reffum/digitizer/docs/Подключение АЦП к плате ZYBO.odt

# Подключение платы АЦП к ZYBO.

Для подключения LVDS линий от АЦП можно использовать разъемы, которые на схеме подключены к цепям JA, JB, JC, JD. Можно также использовать линии HDMI. Clock АЦП нужно подключить к HDMI_CLK или к JD3_P/JD3_N.

Важное замечание. Если данные передаются в формате LVDS, то нужно поставить терминирующий резистор 100 Ом, либо на стороне приемника , либо на стороне передатчика. Лучше разумеется на стороне приемника, то есть на плате.

## Подключение SPI

Линии SPI подключаются к порту MIO Pmod

Линия | На разъеме MIO Pmod | На АЦП | На hmc987lp5e
MOSI(MIO_10) | JF2 | SDIO | SDI
MISO(MIO_11) | JF3
SCK(MIO_12) | JF4 | SCLK | SCLK
SS0(MIO_13) | JF1 | CSB
MIO_0 | JF7 | | SEN
