reffum/digitizer/(commit log)

2020-03-22 Create first template project.
    Approximately assign I/O for ADC LVDS inputs and clock.
2020-03-26 Add local IP repository ip_repo and add my IP for input ADC data.
2020-03-26 Add DMA to block design.
2020-04-07 Fix connectoin of adc_clk. Save DMA destination memory contents to file data.bin.
    [tb.sv]
2020-04-08 Improve testbench for adc_input. Replace number with constants and parameters. But adc input data not tested.
    [tb.sv]
2020-04-08 Add generation ADC test data.
    Generate continuous increment data on adc input.
2020-04-08 Fix error.
    ADC DATA has 16 width.
    [tb.sv]
2020-04-08 Fix errors while debug.
    In modbus.c add debug print.
2020-04-10 Fix errors in data_receiver.sv. There was no wating data in FIFO.
    [data_receiver.sv]
2020-04-10 Add the ability write word to SPI by MODUBS.
2020-04-13 Add IP for adc16dv160 and add it to project. Add code for CLKDIST and ADC initialization.
2020-04-14 Add 2 new files pwm.c and pwm.h.
2020-04-14 Reconnect ADC inputs.
2020-04-18 Add function for set SPI MOSI to TRI
2020-04-18 Fix error. It is no longer adc_input module in this project. I replace it wit adc16dv160. But there is a old ADC_INPUT_BASEADDRES macro remain on dma_test.
    [adc_input.c]
2020-04-18 In spi.c add capabilities for set MOSI in tristate. And add 2 new function for half-duplex write and read on one sdio line. This is needed for read data from ADC.
2020-04-18 Add header for adc functions.
2020-04-18 Add function for write and read ADC registers. Made small changes in spi.c
2020-04-18 Change ADC control MODBUS logic.
2020-04-19 Fix error in digitizer.v. Add one more false path.
    [digitizer.v, timings.xdc]
2020-04-20 Add 160 MHz clock from hdmi_d0_p/n. IOSTANDARD TMDS_33. Add adc inputs to debug ILA.
2020-04-23 Fix error with ADC data receive.
    [adc16dv160.sv, adc16dv160_input.sv, tb.sv]
2020-04-24 Fix timins with ADC.
    Add timing constrains for adc inputs.
    In adc16dv160_input add IODEALY module for each data input. And add REFCLK 200 MHz for IODELAYCTRL.
    clock for IDDR route throw BUFIO. For FIFO throw BUFG.
    Connect ADC clock to jd_p[2], so that ADC clock and data are connected in one I/O band.
    Tune IDLEAY_VALUE for IDELAY2 module in adc_data[0] and adc_data[1] path. This path was failed while timing checks. After this tune, timing check is OK.
    Add debug.xdc in project.
    [Zybo-Master.xdc, adc16dv160.sv, adc16dv160_input.sv, digitizer.v, tb.sv, timings.xdc]
2020-04-24 Not init ADC at startup.
2020-04-25 Make LVCMOS 100 MHz output in HDMI_D0_N pin
2020-04-29 Add SPI interface for control AD9854.
    This DDS is controlled throw MDOBUS.
2020-04-30 Fix error with SPI and AD9854 control.
    [ad9854.c, gpio.c, spi.c, spi.h]
2020-05-01 Add control for IO RESET pin.
2020-05-04 Fix MODBUS register addr.
    [regs.c]
2020-05-05 Fix error. Data size for ADC IP was setting 4 times more, then needed.
    [adc_input.c, regs.c]
2020-05-07 Add ADC_EN port.
    Add EMIO 4 and connect it toJE8.
    20 us before start of ADC receive port ADC_EN become 1. It become 0, when receive complete.
2020-05-07 Fix error. ADC_EN pin was not initialized.
    [gpio.c, regs.c]
2020-08-08 - Change IDELAY value for D13/12 ADC line to 25. - Change Implementation strategy to "Performance_ExtraTimingOpt"
2020-08-13 Change level synchronization logic.
    - Change Level synchronization logic. Now it start when it receive at least one sample less then threshold. When level_sync receive for a given amount samples more then threshold consecutively, sync stop. (see docs/digitizer.eapx for details).
    - Remove AdcData.data for git.
2020-08-31 Add N-pulse PWM mode.
2020-09-13 Add test files. Fix errors.
    [axi_stream_receiver.sv, lvds_input.sv, lvds_input_axi_read.sv, lvds_input_data_receiver.sv, lvds_input_write.sv, tb.sv]
2020-09-30 Connect SELA and SELC to PWM output.
